DanInvents/Rockit/(threads)

Thread 1 (2023-08-02):

Request a feature (toggle) to switch ports high to use electric igniters for dual chute deployment instead of servo operation

frankbezema, 2023-08-02:
Instead of opertating servo's simply make the ports go high to drive a MOSFET which triggers an electric igniter in a small cillinder of black powder. This can be used in a classic dual chute deployment.
The ports should be always in a down state and only go high when several conditions are met.

DanInvents, 2023-08-07:
Hi Frank! Thank you for your comment and sorry for the late reply.

The solution that you suggested is doable, but it has some shortcomings. You could use a MOSFET as a current sink with the output from the DC-DC converter (5V) as the power source. The problem with doing this is that a pyrotechnic igniter would be seen as a short and it could momentarily collapse the 5V rail which powers the microcontroller with catastrophic consequences.

If one would use the battery as a power source instead, it could provide the necessary power while the DC-DC converter remains operational. The problem with this approach is that the battery voltage changes and so would the current flowing through the MOSFET.

I have come up with an alternative solution and I'm currently designing a new flight computer that will allow to fire pyrotechnic charges. The progress has been slower than what I expected because of personal reasons but it is steady.

All the best,

Daniel

frankbezema, 2023-08-11:
Hello Daniel,
I'd really like to make this work with the current flight computer (which I already bought). I am going to use a 3S LiPo (11.1V, 450mAh, 30C) as powersource to use the MOSFETs (BUZ11), together with a mosfet driver chip (ta4427A), to reliably set off the pyrotechnic charges.
Do you know if the board will keep the ports in a low state, even when powering up, or  are pull down resistors needed? Can't have the charges go off by accident when starting up. arduino's had this happening with a bootloader.
Have to check this anyway with a memory oscilloscope.
All the best,
Frank.

DanInvents, 2023-08-12:
Hi Frank!

If you intend to use a 3S lipo battery to power Rockit remember to step down the voltage first. Such a high voltage would destroy the device.

About the state of the GPIO pins. I think that they are LOW at startup and they remain LOW. I will check next week with an oscilloscope and get back to you.

All the best,

Daniel

DanInvents, 2023-08-16:
I have checked the GPIO port that drives the servo motor and which could we configured to fire pyrotechnic charges. The port stays LOW even during the booting sequence. It outputs a PWM signal to drive the servo on demand. It is straightforward to modify the code so that the GPIO goes HIGH to fire a pyrotechnic charge.

-Daniel

ranguli, 2023-10-19:
> I'm currently designing a new flight computer that will allow to fire pyrotechnic charges.

Hi @DanInvents, just wondering if this new flight computer would be a new revision of the Rockit board or a completely different product?

All the best!
Joshua

Thread 4 (2023-10-16):

Suggestion: Open-source CAD design files / PCB files

ranguli, 2023-10-16:
I would like to propose the idea of open-sourcing the PCB / CAD design files for Rockit. I think this would bring a lot of potential benefits to the project:

- **Allow collaboration and foster innovation:** If the design files are open-sourced, the community can make contributions and help improve the Rockit hardware for future revisions, potentially adding new features, capabilities, or fix issues.
- **Educational value:** For any Rockit users who are learning about micro-controllers, electronics, CAD, and PCB design, having the design files open-sourced would allow exploration into how the Rockit works and would serve as a valuable educational asset.
- **Increased adoption:** If the platform is open-sourced, it could lead to wider adoption among hobbyists wishing to embrace an open platform, potentially even leading to integrations with other open-source hardware or Rockit expansion shields/hats built on an open standard.

Thanks for considering this suggestion, as well as for all your fantastic work on the Rockit.

Thread 5 (2024-08-15):

Possibility to use/break out serial lines on Rockit? Maybe reassign statusled and beep pins? Would like to keep pressure sensor, which uses the I2C.

frankbezema, 2024-08-15:
I'd like to use a serial device on the rockit, a SIM7670E GPS/LTE modem. Any idea's to get a serial (115200 baud) port available from the Rockit board?

DanInvents, 2024-08-19:
Sorry for the late reply, the only way I can come up with is to use a
I2C-to-serial converter. Perhaps something like this would work?
https://www.dfrobot.com/product-2001.html

On Thu, Aug 15, 2024 at 11:34 AM frankbezema ***@***.***>
wrote:

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
