DanInvents/Rockit/Schematic_Rockit Rev 1.pdf

Data Logging | Interfacing

RP2040

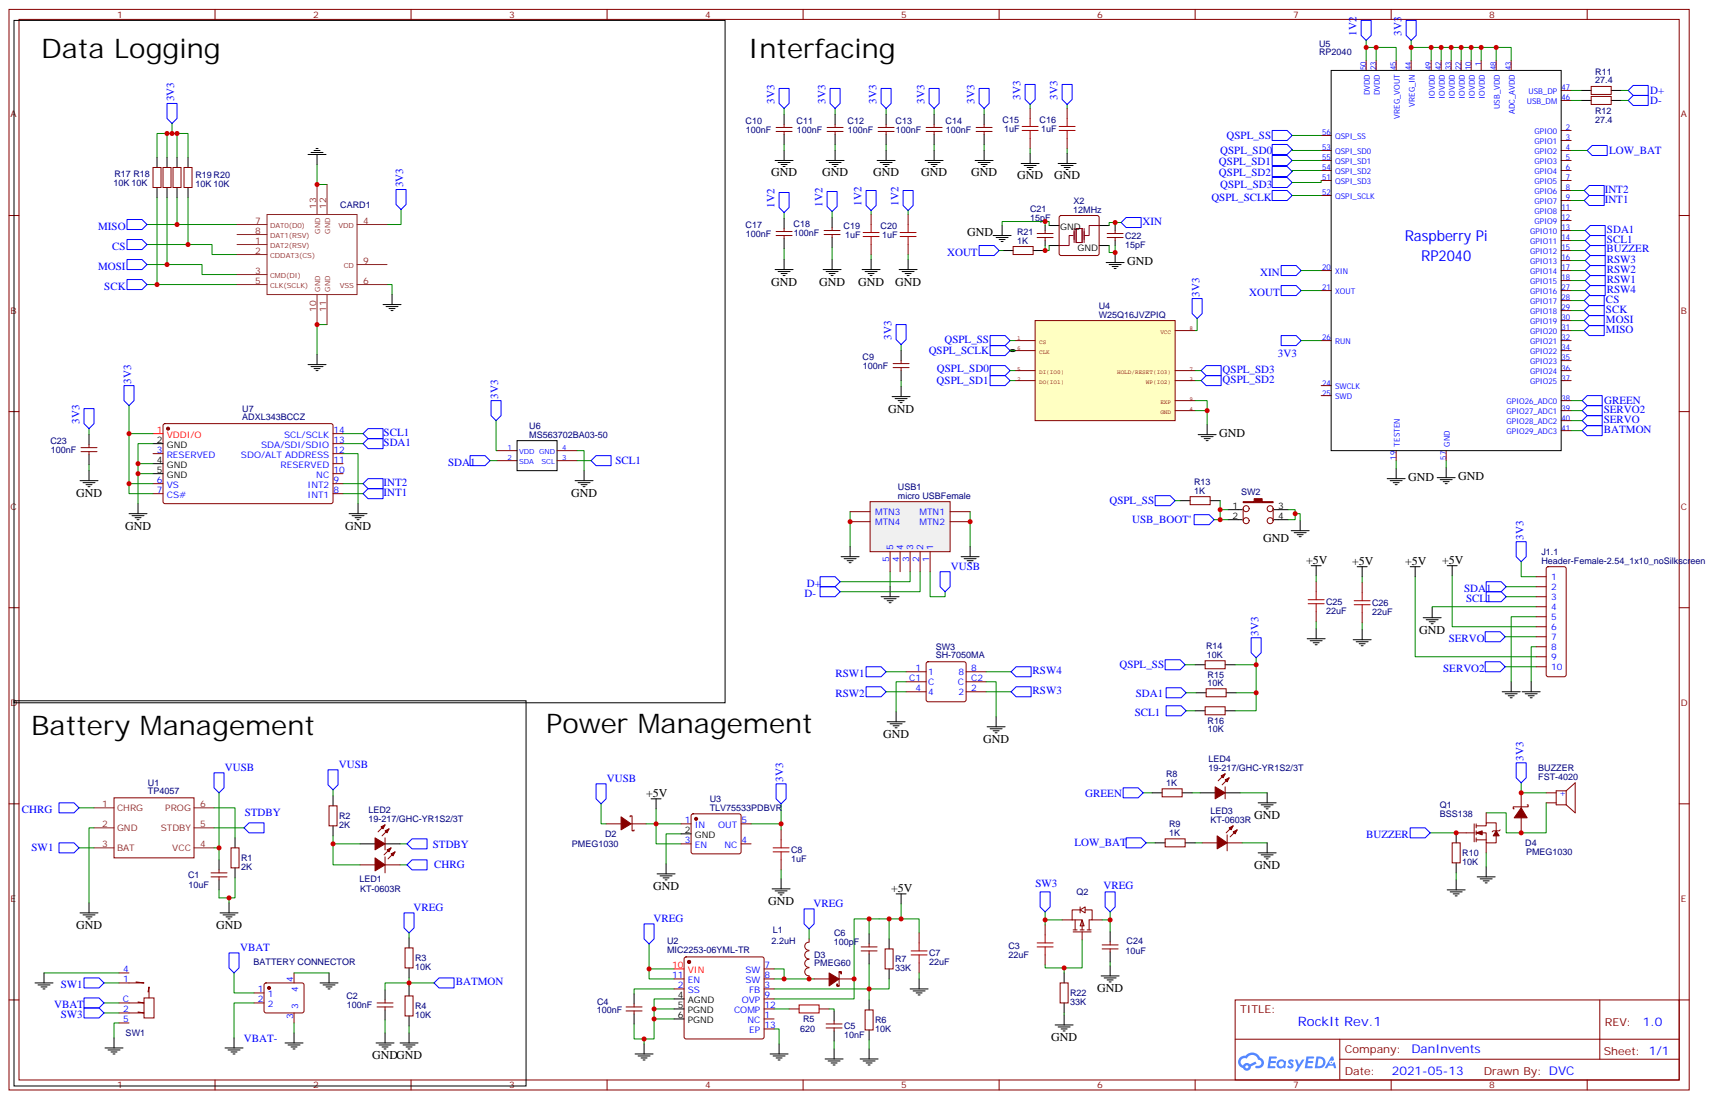
[picture p6: page 1]

ADXL343BCCZ
NC 10 RESERVED 11 SDO/ALT ADDRESS 12 SDA/SDI/SDIO 13 SCL/SCLK 14
