DanInvents/Rockit/Firmware/complementary_coded_rotary_switch/Rev 2.2/control/batteryStatus.ino

void batteryStatus(){
  if ((2*analogRead(29)*3.3/(pow(2,12)-1)) < 3.8){
    digitalWrite(batLED, HIGH);
  }
  else if ((2*analogRead(29)*3.3/(pow(2,12)-1)) > 3.8){
    digitalWrite(batLED, LOW);
  }
}
