DanInvents/Rockit/(commit log)

2022-08-17 Add files via upload
    // Fixed a bug that made the piezo buzzer and the blue LED stay on once launch was detected.
    // Selecting the position 3 of the rotary switch allows you to test the servo motors. Servo motor 1 moves from its initial to its final position followed by servo 2 3 seconds later.
    // By using position 3 to test the servos you avoid creating unnecessary files in your microSD card.
    // Wait for 10 seconds to allow the rocketeer to prepare for launch before the flight computer is armed this avoids creating unnecesary files in your microSD card.
    [SDstartup.ino, batteryStatus.ino, beepnblink.ino, control.ino, kalmanFilter.ino, preLaunch.ino, recovery.ino, rotSwitch.ino]
2024-01-30 Add files via upload
    Added circuit dimensions to the user manual
2024-03-14 Add files via upload
    Upgraded the servo motor control. Now you can rotate an MG90s servo motor 180 degrees.
